JaredTCan/NanoSAM/NanoSAM/nanoSAM_Schematic.pdf

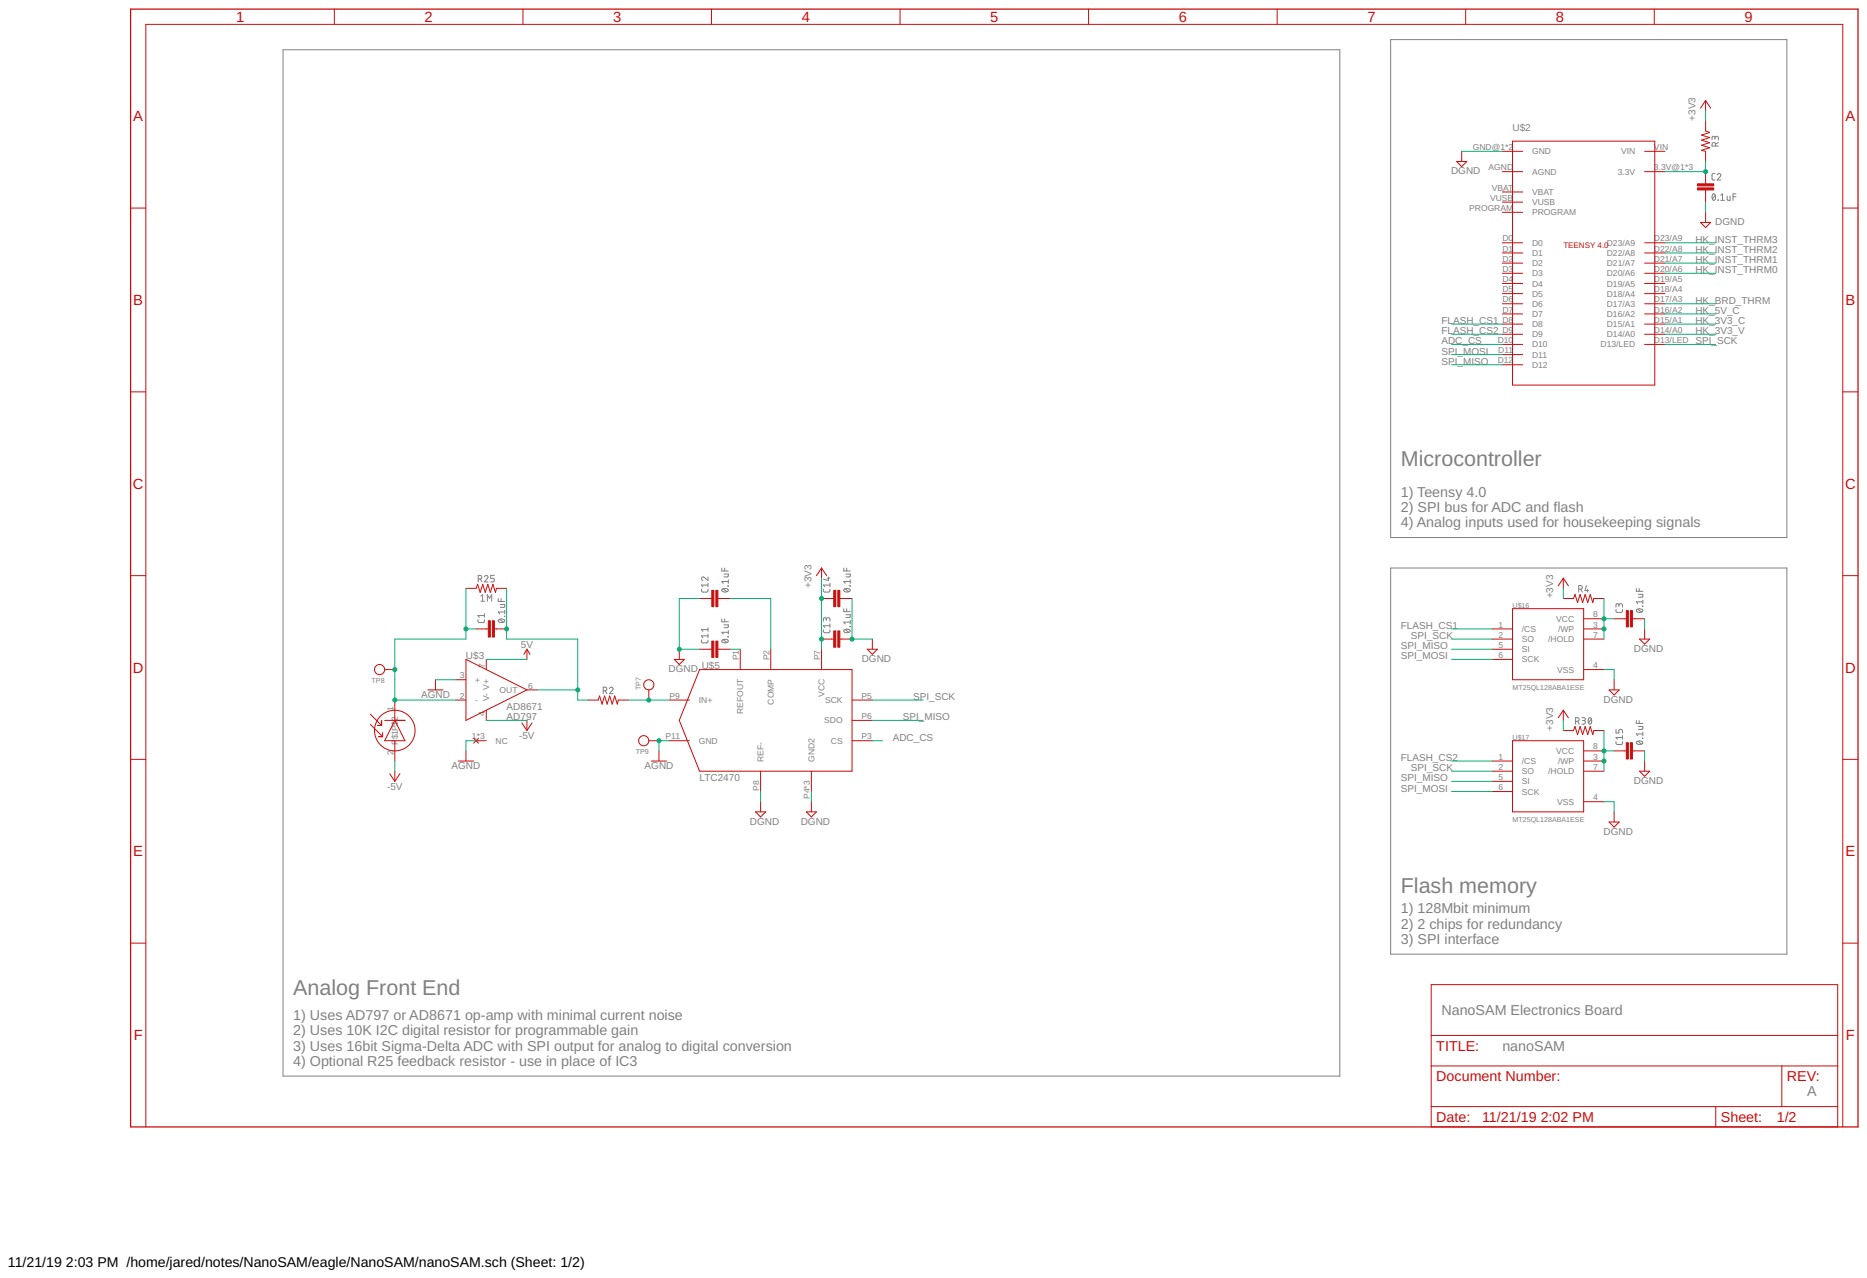
[picture p1: page 1]

1) Teensy 4.0
2) SPI bus for ADC and flash
4) Analog inputs used for housekeeping signals

1) Uses AD797 or AD8671 op-amp with minimal current noise
2) Uses 10K I2C digital resistor for programmable gain
3) Uses 16bit Sigma-Delta ADC with SPI output for analog to digital conversion
4) Optional R25 feedback resistor - use in place of IC3

Document Number: | REV: A

Date: 11/21/19 2:02 PM | Sheet: 1/2

11/21/19 2:03 PM /home/jared/notes/NanoSAM/eagle/NanoSAM/nanoSAM.sch (Sheet: 1/2)

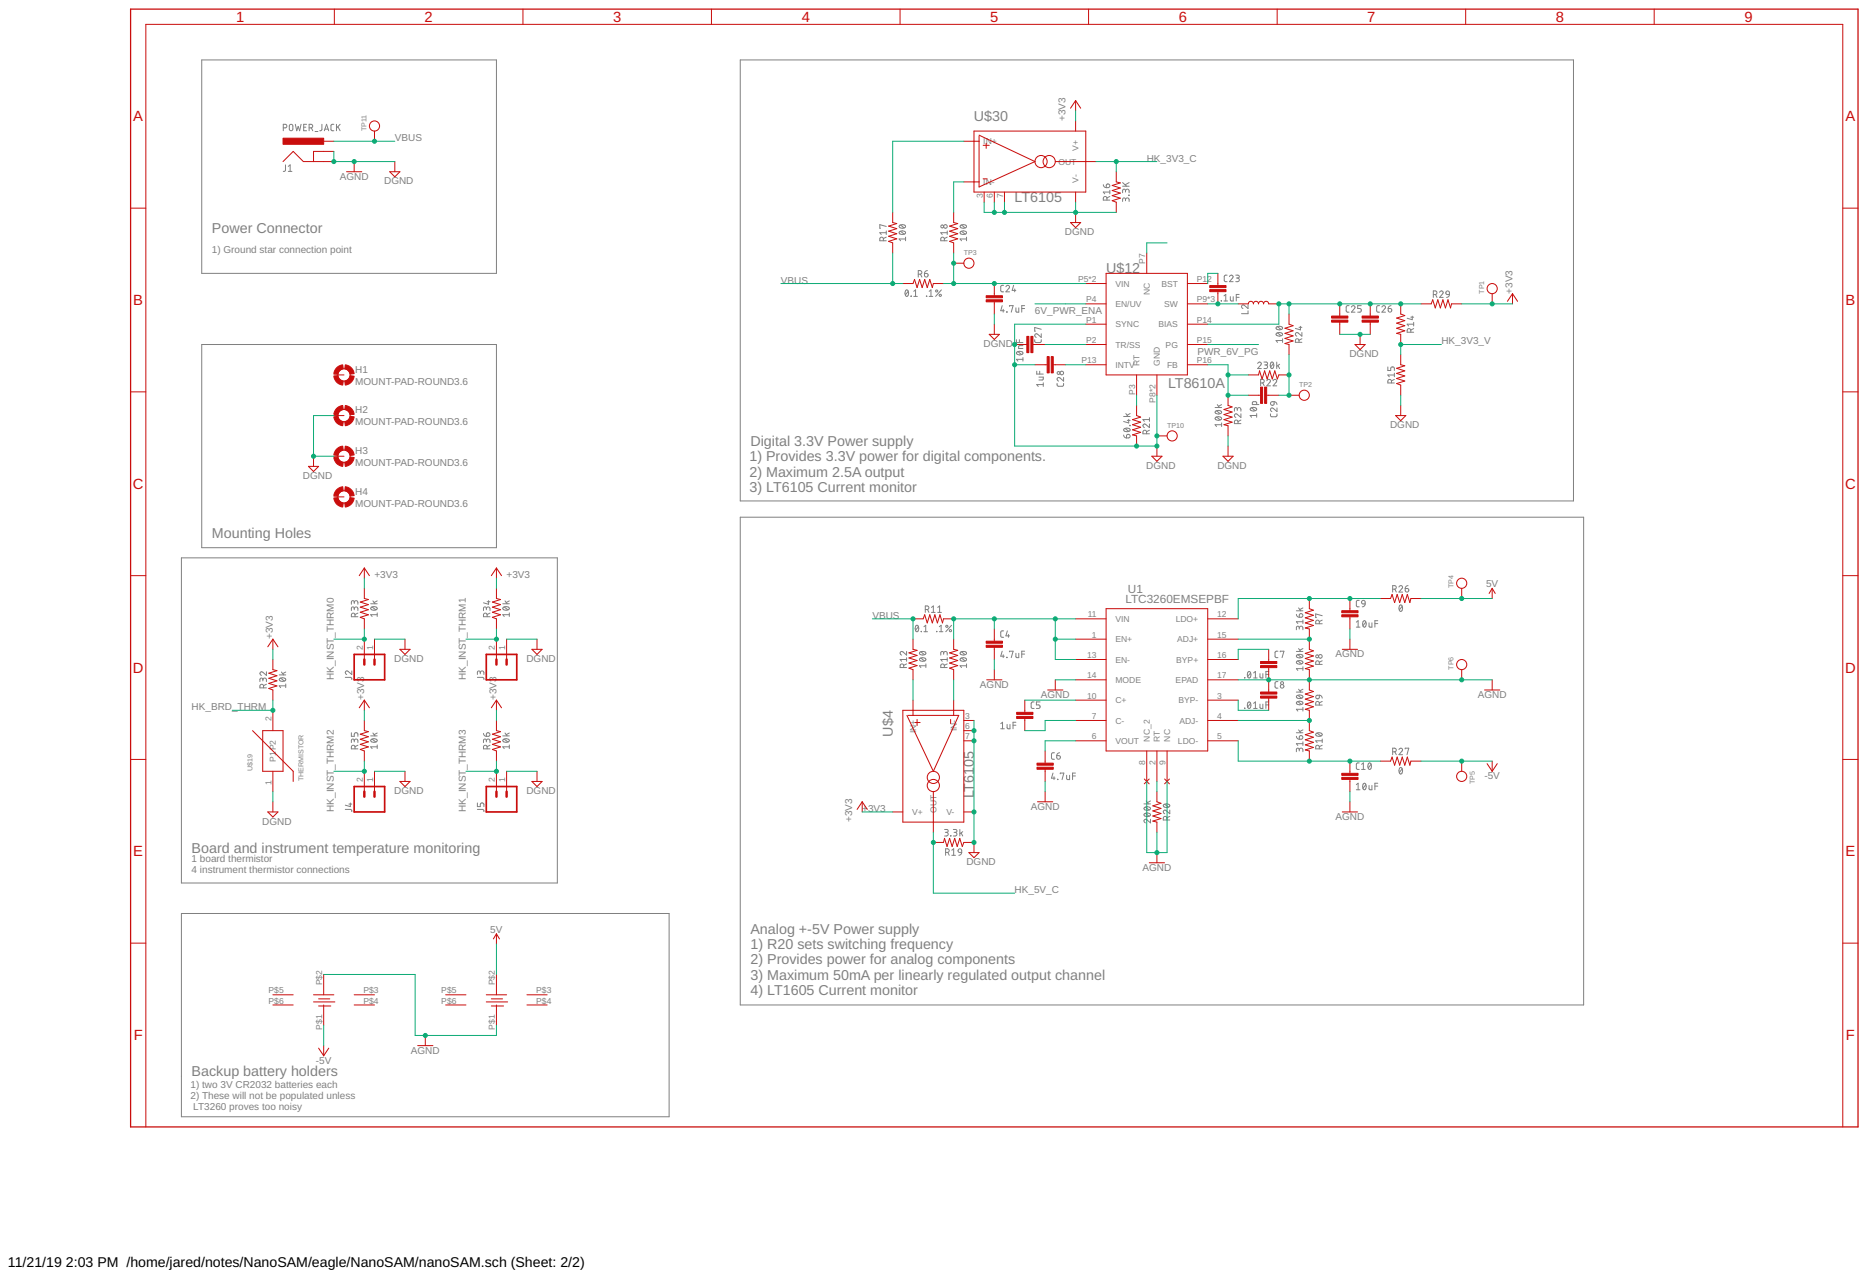
[picture p2: page 2]

1) Ground star connection point

Digital 3.3V Power supply
1) Provides 3.3V power for digital components. 2) Maximum 2.5A output
3) LT6105 Current monitor

Board and instrument temperature monitoring
1 board thermistor 4 instrument thermistor connections

Analog +-5V Power supply
1) R20 sets switching frequency
2) Provides power for analog components
3) Maximum 50mA per linearly regulated output channel
4) LT1605 Current monitor

Backup battery holders
1) two 3V CR2032 batteries each
2) These will not be populated unless LT3260 proves too noisy

11/21/19 2:03 PM /home/jared/notes/NanoSAM/eagle/NanoSAM/nanoSAM.sch (Sheet: 2/2)
