JaredTCan/NanoSAM/NanoSAM/nanoSAM.brd

## EAGLE design NanoSAM/nanoSAM.brd (2020-03-12)

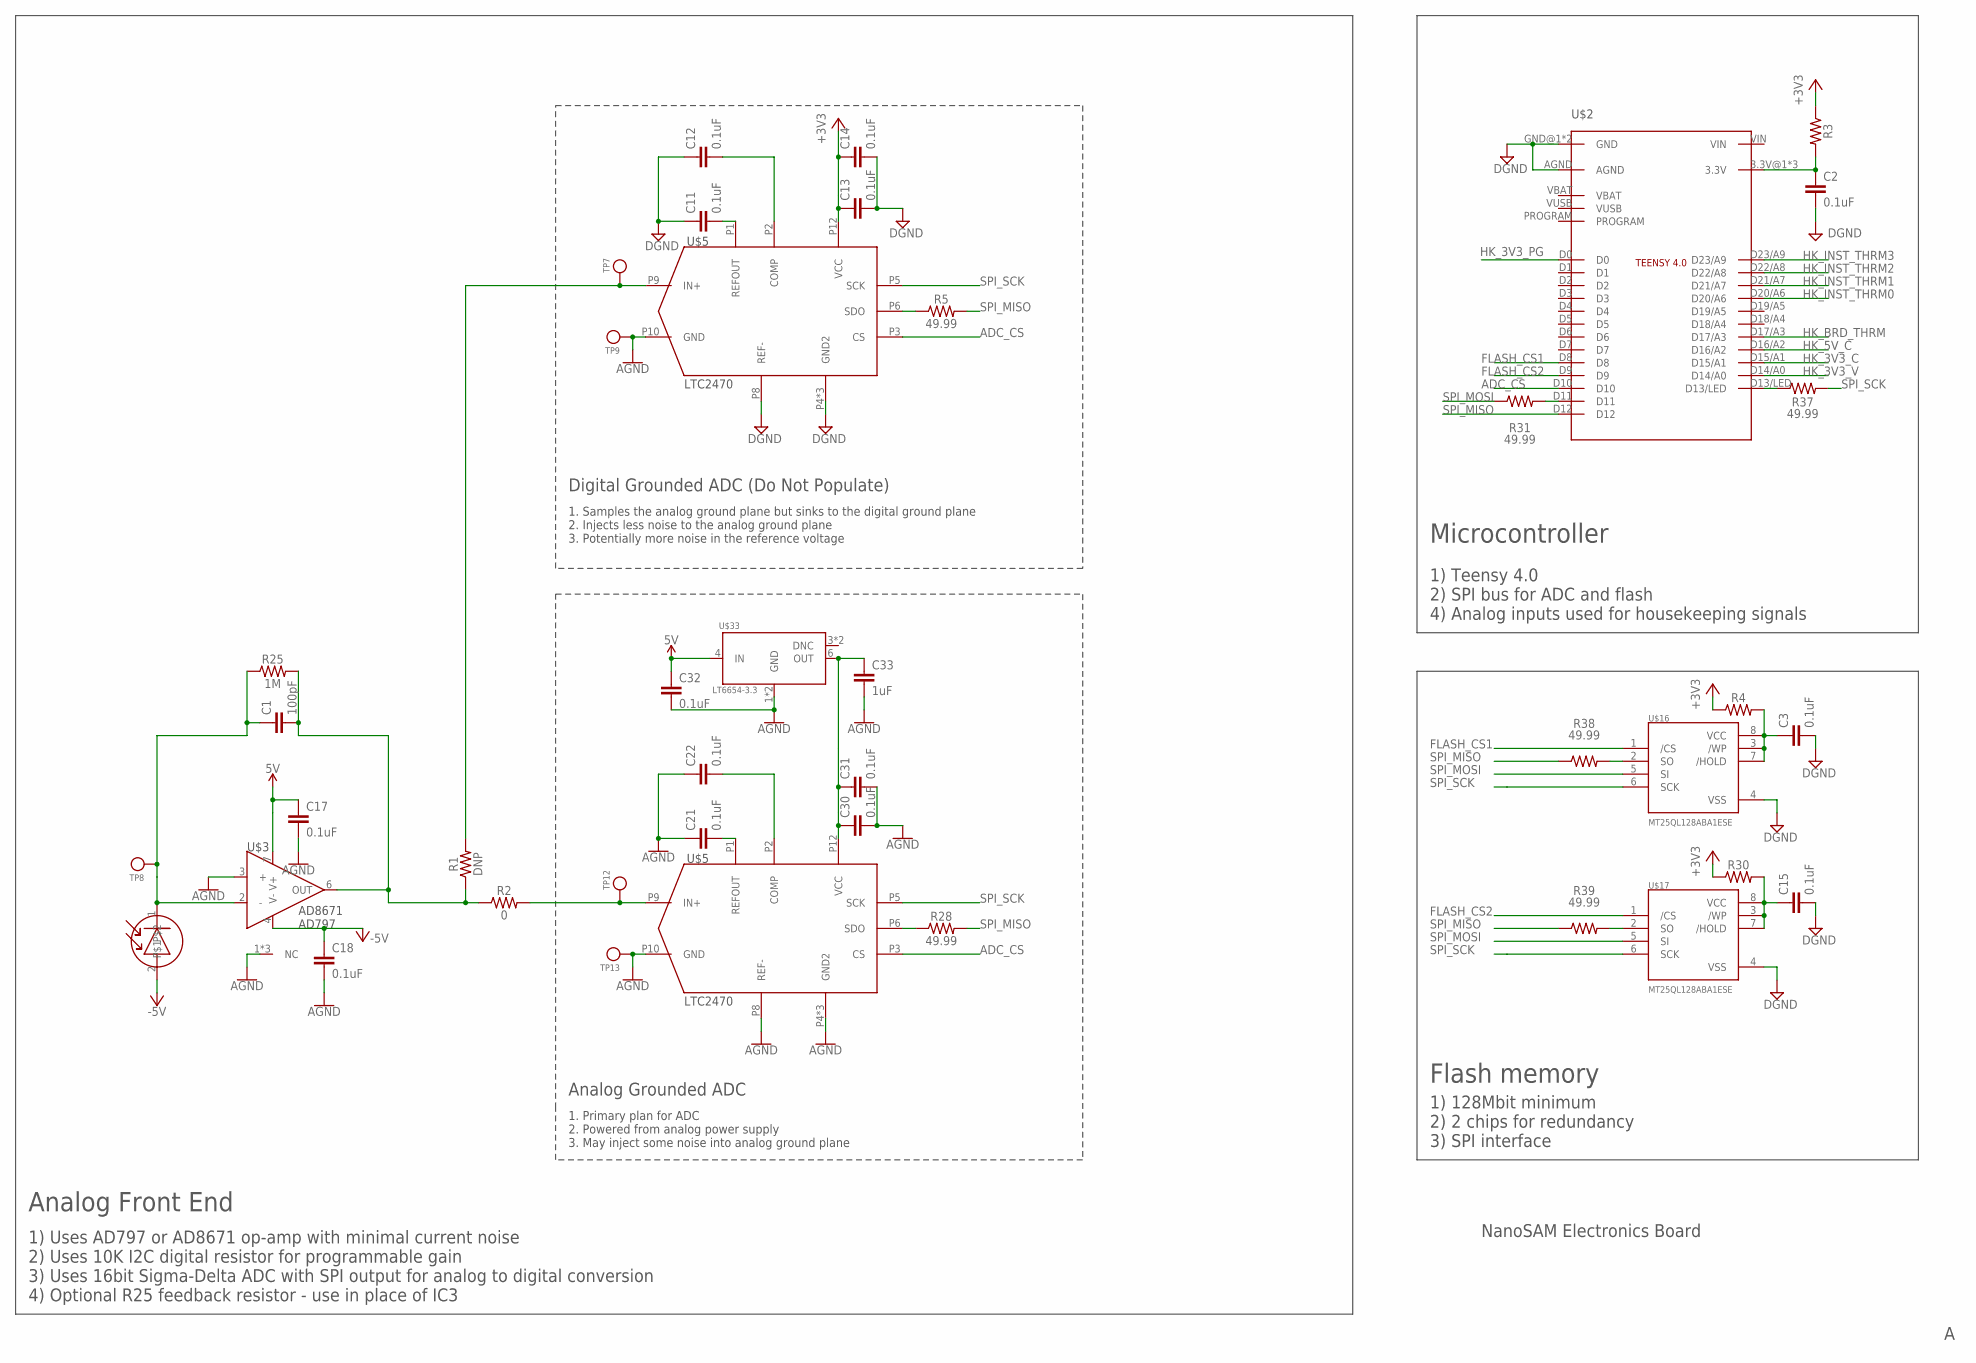
[picture p3: schematic nanoSAM.sch, sheet 1]

Parts:
C1: 100pF; 0603
C2, C3, C11, C12, C13, C14, C15, C17, C18, C21, C22, C30, C31, C32: 0.1uF; 0603
C33: 1uF; 0603
R1: DNP; 0805
R2: 0; 0805
R3, R4, R30: 0805
R5, R28, R31, R37, R38, R39: 49.99; 0805
R25: 1M; 0805
TP7, TP8, TP9, TP12, TP13: TESTPOINT; 1X01
U$1: PHOTODIODESYMBOLPD_CONN; 1X02
U$2: TEENSY4.0
U$3: AD8671; SO8
U$5, U$26: LTC2470; MSOP12
U$16, U$17: MT25QL128ABA1ESE; SO-08M
U$33: LT6654-3.3; SOT23-6L

Connections:
5V: C17.1, C32.1, U$3.7 (V+), U$33.4 (IN); also elsewhere on the board
+3V3: C13.1, C14.1, R3.1, R4.1, R30.1, U$5.P12 (VCC); also elsewhere on the board
-5V: C18.1, U$1.2, U$3.4 (V-); also elsewhere on the board
ADC_CS: U$2.D10, U$5.P3 (CS), U$26.P3 (CS)
AGND: C17.2, C18.2, C21.1, C22.1, C30.2, C31.2, C32.2, C33.2, TP9.1, TP13.1, U$3.1 (NC), U$3.3 (+), U$3.5 (NC), U$3.8 (NC), U$5.P10 (GND), U$26.P4 (GND2), U$26.P7 (GND2), U$26.P8 (REF-), U$26.P10 (GND), U$26.P11 (GND2), U$33.1 (GND), U$33.2 (GND); also elsewhere on the board
DGND: C2.2, C3.2, C11.1, C12.1, C13.2, C14.2, C15.2, U$2.AGND, U$2.GND@1 (GND), U$2.GND@2 (GND), U$5.P4 (GND2), U$5.P7 (GND2), U$5.P8 (REF-), U$5.P11 (GND2), U$16.4 (VSS), U$17.4 (VSS); also elsewhere on the board
FLASH_CS1: U$2.D8, U$16.1 (/CS)
FLASH_CS2: U$2.D9, U$17.1 (/CS)
HK_3V3_C: U$2.D15/A1; also elsewhere on the board
HK_3V3_PG: U$2.D0; also elsewhere on the board
HK_3V3_V: U$2.D14/A0; also elsewhere on the board
HK_5V_C: U$2.D16/A2; also elsewhere on the board
HK_BRD_THRM: U$2.D17/A3; also elsewhere on the board
HK_INST_THRM0: U$2.D20/A6; also elsewhere on the board
HK_INST_THRM1: U$2.D21/A7; also elsewhere on the board
HK_INST_THRM2: U$2.D22/A8; also elsewhere on the board
HK_INST_THRM3: U$2.D23/A9; also elsewhere on the board
unnamed: C1.1, R25.1, TP8.1, U$1.1, U$3.2 (-)
unnamed: C1.2, R1.1, R2.1, R25.2, U$3.6 (OUT)
unnamed: R1.2, TP7.1, U$5.P9 (IN+)
unnamed: C2.1, R3.2, U$2.3.3V@1 (3.3V), U$2.3.3V@2 (3.3V), U$2.ON/OFF (3.3V)
unnamed: R2.2, TP12.1, U$26.P9 (IN+)
unnamed: C3.1, R4.2, U$16.3 (/WP), U$16.7 (/HOLD), U$16.8 (VCC)
unnamed: C22.2, U$26.P2 (COMP)
unnamed: C12.2, U$5.P2 (COMP)
unnamed: C11.2, U$5.P1 (REFOUT)
unnamed: C21.2, U$26.P1 (REFOUT)
unnamed: C30.1, C31.1, C33.1, U$26.P12 (VCC), U$33.6 (OUT)
unnamed: C15.1, R30.2, U$17.3 (/WP), U$17.7 (/HOLD), U$17.8 (VCC)
unnamed: R5.1, U$5.P6 (SDO)
unnamed: R28.1, U$26.P6 (SDO)
unnamed: R31.2, U$2.D11
unnamed: R37.1, U$2.D13/LED
unnamed: R38.2, U$16.2 (SO)
unnamed: R39.2, U$17.2 (SO)
SPI_MISO: R5.2, R28.2, R38.1, R39.1, U$2.D12
SPI_MOSI: R31.1, U$16.5 (SI), U$17.5 (SI)
SPI_SCK: R37.2, U$5.P5 (SCK), U$16.6 (SCK), U$17.6 (SCK), U$26.P5 (SCK)

Notes on the sheet:
Analog Front End
Microcontroller
Flash memory
1) Uses AD797 or AD8671 op-amp with minimal current noise 2) Uses 10K I2C digital resistor for programmable gain 3) Uses 16bit Sigma-Delta ADC with SPI output for analog to digital conversion 4) Optional R25 feedback resistor - use in place of IC3
1) Teensy 4.0 2) SPI bus for ADC and flash 4) Analog inputs used for housekeeping signals
1) 128Mbit minimum 2) 2 chips for redundancy 3) SPI interface
AD8671 AD797
U$3
U$2
LTC2470
U$5
NanoSAM Electronics Board
Analog Grounded ADC
1. Primary plan for ADC 2. Powered from analog power supply 3. May inject some noise into analog ground plane
Digital Grounded ADC (Do Not Populate)
1. Samples the analog ground plane but sinks to the digital ground plane 2. Injects less noise to the analog ground plane 3. Potentially more noise in the reference voltage

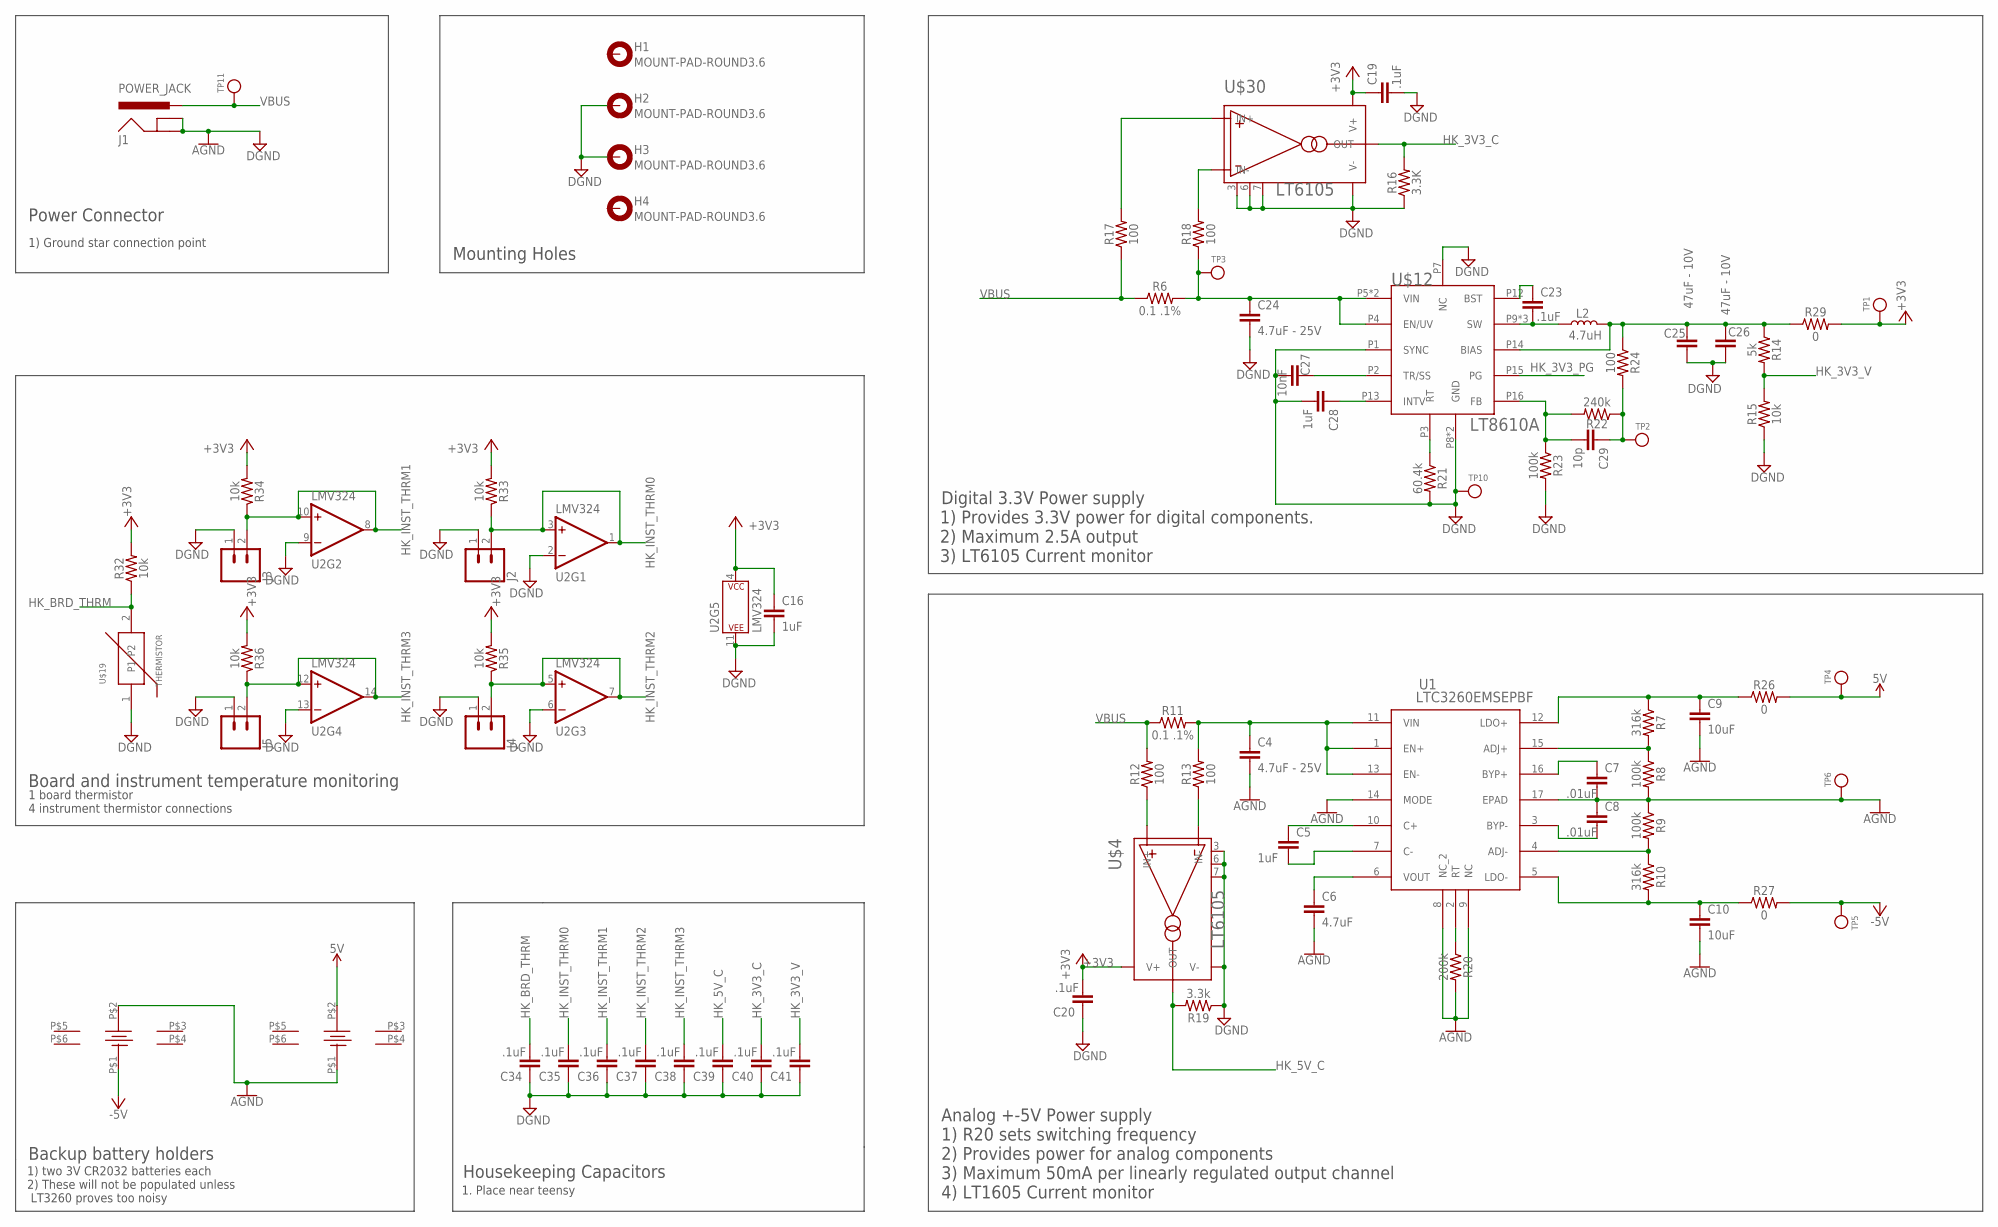
[picture p4: schematic nanoSAM.sch, sheet 2]

Parts:
C4, C24: 4.7uF - 25V; 1206
C5: 1uF; 1206
C6: 4.7uF; 1206
C7, C8: .01uF; 1206
C9, C10: 10uF; 1206
C16, C28: 1uF; 0603
C19, C20, C23, C34, C35, C36, C37, C38, C39, C40, C41: .1uF; 0603
C25, C26: 47uF - 10V; 1210
C27: 10nF; 0603
C29: 10p; 0603
H1, H2, H3, H4: MOUNT-PAD-ROUND3.6; 3,6-PAD
J1: POWER_JACK; POWER_JACK_PTH
J2, J3, J4, J5: CONN_02; 1X02
L2: 4.7uH; WE-HCI
R6, R11: 0.1 .1%; 1206
R7, R10: 316k; 0603
R8, R9, R23: 100k; 0603
R12, R13, R17, R18, R24: 100; 0603
R14: 5k; 0603
R15: 10k; 0603
R16: 3.3K; 0603
R19: 3.3k; 0603
R20: 200k; 0603
R21: 60.4k; 0603
R22: 240k; 0603
R26, R27: 0; 0603
R29: 0; 1206
R32, R33, R34, R35, R36: 10k; 1206
TP1, TP2, TP3, TP4, TP5, TP6, TP10, TP11: TESTPOINT; 1X01
U1: LTC3260EMSEPBF; MSOP-16_MSE
U2: LMV324; SO14
U$4, U$30: LT6105; MSOP8
U$12: LT8610A; MSOP16
U$19: THERMISTOR; M0805
U$20, U$21: CR2032

Connections:
5V: R26.2, TP4.1, U$21.P$2; also elsewhere on the board
+3V3: C16.1, C19.1, C20.2, R29.2, R32.2, R33.2, R34.2, R35.2, R36.2, TP1.1, U2.4 (P$V+), U$4.2 (V+), U$30.2 (V+); also elsewhere on the board
-5V: R27.2, TP5.1, U$20.P$1; also elsewhere on the board
AGND: C4.2, C6.2, C7.2, C8.1, C9.2, C10.2, R8.2, R9.1, R20.2, TP6.1, U1.8 (NC_2), U1.9 (NC), U1.14 (MODE), U1.17 (EPAD), U$20.P$2, U$21.P$1; also elsewhere on the board
DGND: C16.2, C19.2, C20.1, C24.2, C25.2, C26.2, C27.2, C28.2, C34.1, C35.1, C36.1, C37.1, C38.1, C39.1, C40.1, C41.1, H2.B3,6, H3.B3,6, J1.GND, J1.GNDBREAK, J2.1, J3.1, J4.1, J5.1, R15.1, R16.1, R19.1, R21.2, R23.2, TP10.1, U2.2 (-IN), U2.6 (-IN), U2.9 (-IN), U2.11 (P$V-), U2.13 (-IN), U$4.3, U$4.4 (V-), U$4.6, U$4.7, U$12.P1 (SYNC), U$12.P7 (NC), U$12.P8 (GND), U$12.P17 (GND), U$19.1, U$30.3, U$30.4 (V-), U$30.6, U$30.7; also elsewhere on the board
HK_3V3_C: C40.2, R16.2, U$30.5 (OUT); also elsewhere on the board
HK_3V3_PG: U$12.P15 (PG); also elsewhere on the board
HK_3V3_V: C41.2, R14.2, R15.2; also elsewhere on the board
HK_5V_C: C39.2, R19.2, U$4.5 (OUT); also elsewhere on the board
HK_BRD_THRM: C34.2, R32.1, U$19.2; also elsewhere on the board
HK_INST_THRM0: C35.2, J2.2, R33.1, U2.1 (OUT), U2.3 (+IN); also elsewhere on the board
HK_INST_THRM1: C36.2, J3.2, R34.1, U2.8 (OUT), U2.10 (+IN); also elsewhere on the board
HK_INST_THRM2: C37.2, J4.2, R35.1, U2.5 (+IN), U2.7 (OUT); also elsewhere on the board
HK_INST_THRM3: C38.2, J5.2, R36.1, U2.12 (+IN), U2.14 (OUT); also elsewhere on the board
unnamed: C7.1, U1.16 (BYP+)
unnamed: R7.2, R8.1, U1.15 (ADJ+)
unnamed: C6.1, U1.6 (VOUT)
unnamed: R17.2, U$30.8 (IN+)
unnamed: R9.2, R10.1, U1.4 (ADJ-)
unnamed: R18.2, U$30.1 (IN-)
unnamed: C8.2, U1.3 (BYP-)
unnamed: C4.1, R11.2, R13.2, U1.1 (EN+), U1.11 (VIN), U1.13 (EN-)
unnamed: R12.1, U$4.8 (IN+)
unnamed: R13.1, U$4.1 (IN-)
unnamed: C5.1, U1.10 (C+)
unnamed: C5.2, U1.7 (C-)
unnamed: C9.1, R7.1, R26.1, U1.12 (LDO+)
unnamed: R20.1, U1.2 (RT)
unnamed: C10.1, R10.2, R27.1, U1.5 (LDO-)
unnamed: C28.1, U$12.P13 (INTV)
unnamed: C25.1, C26.1, L2.P$2 (2), R14.1, R24.1, R29.1, U$12.P14 (BIAS)
unnamed: C27.1, U$12.P2 (TR/SS)
unnamed: R21.1, U$12.P3 (RT)
unnamed: C23.1, U$12.P12 (BST)
unnamed: C23.2, L2.P$1 (1), U$12.P9 (SW), U$12.P10 (SW), U$12.P11 (SW)
unnamed: C29.2, R22.2, R23.1, U$12.P16 (FB)
unnamed: C29.1, R22.1, R24.2, TP2.1
unnamed: C24.1, R6.2, R18.1, TP3.1, U$12.P4 (EN/UV), U$12.P5 (VIN), U$12.P6 (VIN)
VBUS: J1.PWR, R6.1, R11.1, R12.2, R17.1, TP11.1

Notes on the sheet:
Digital 3.3V Power supply
Analog +-5V Power supply
Power Connector
1) Ground star connection point
Mounting Holes
1) R20 sets switching frequency 2) Provides power for analog components 3) Maximum 50mA per linearly regulated output channel 4) LT1605 Current monitor
1) Provides 3.3V power for digital components. 2) Maximum 2.5A output 3) LT6105 Current monitor
Board and instrument temperature monitoring
1 board thermistor 4 instrument thermistor connections
Backup battery holders
1) two 3V CR2032 batteries each 2) These will not be populated unless LT3260 proves too noisy
Housekeeping Capacitors
1. Place near teensy

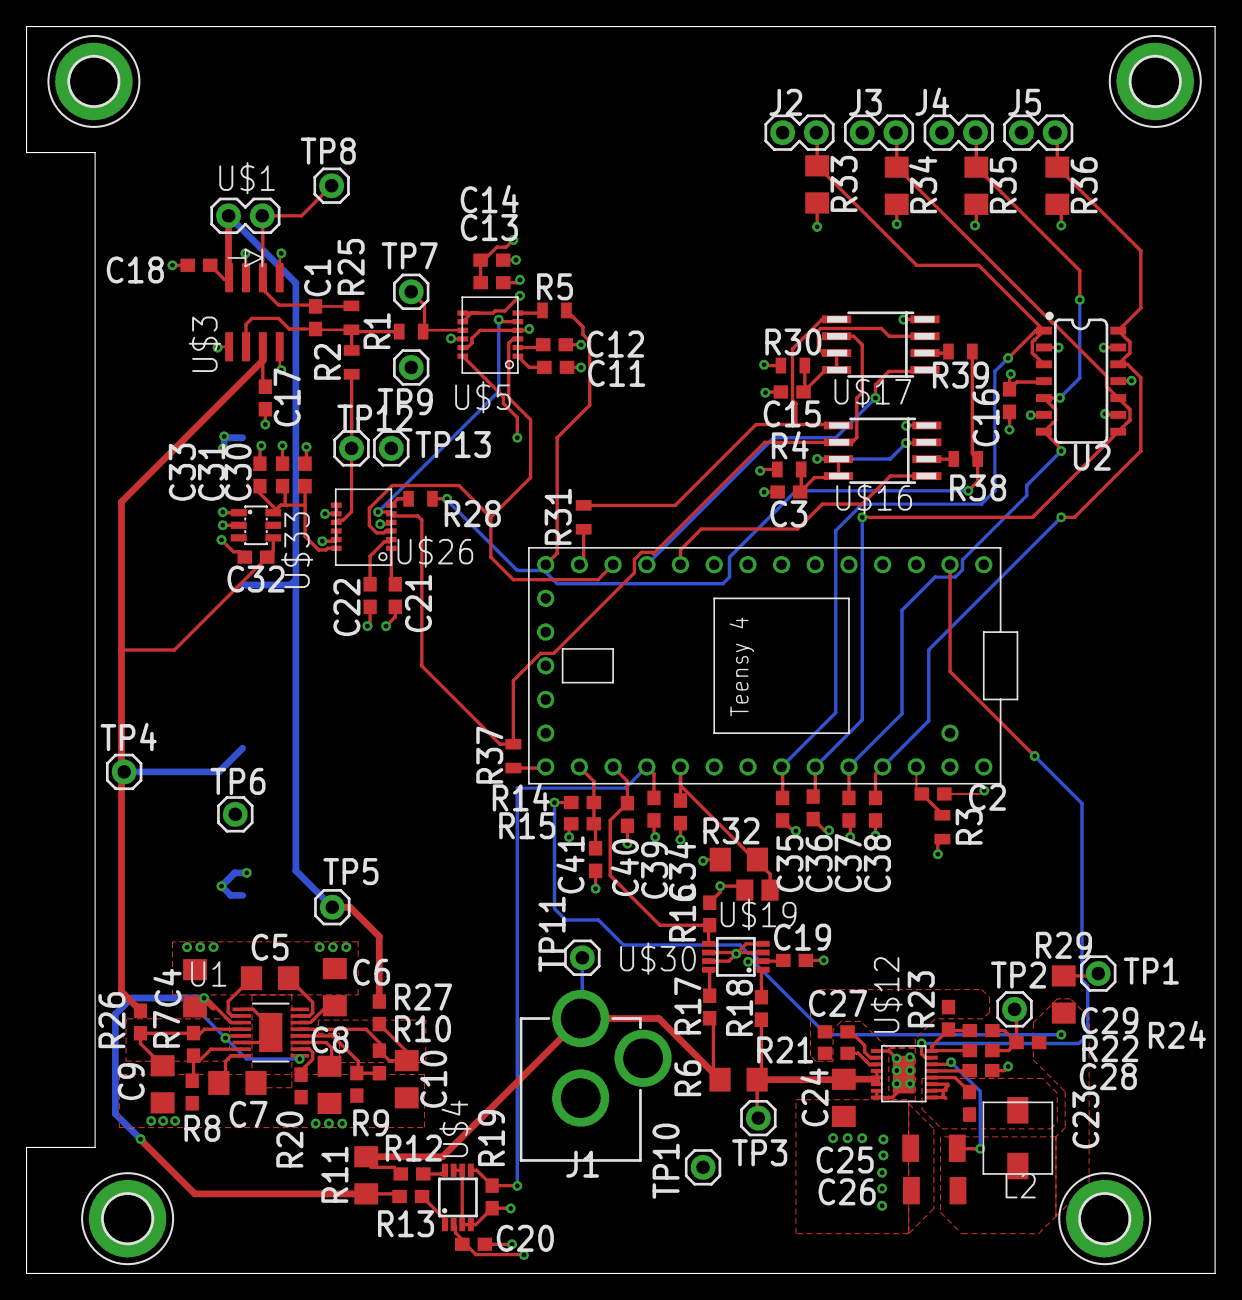
[picture p5: board nanoSAM.brd from above]

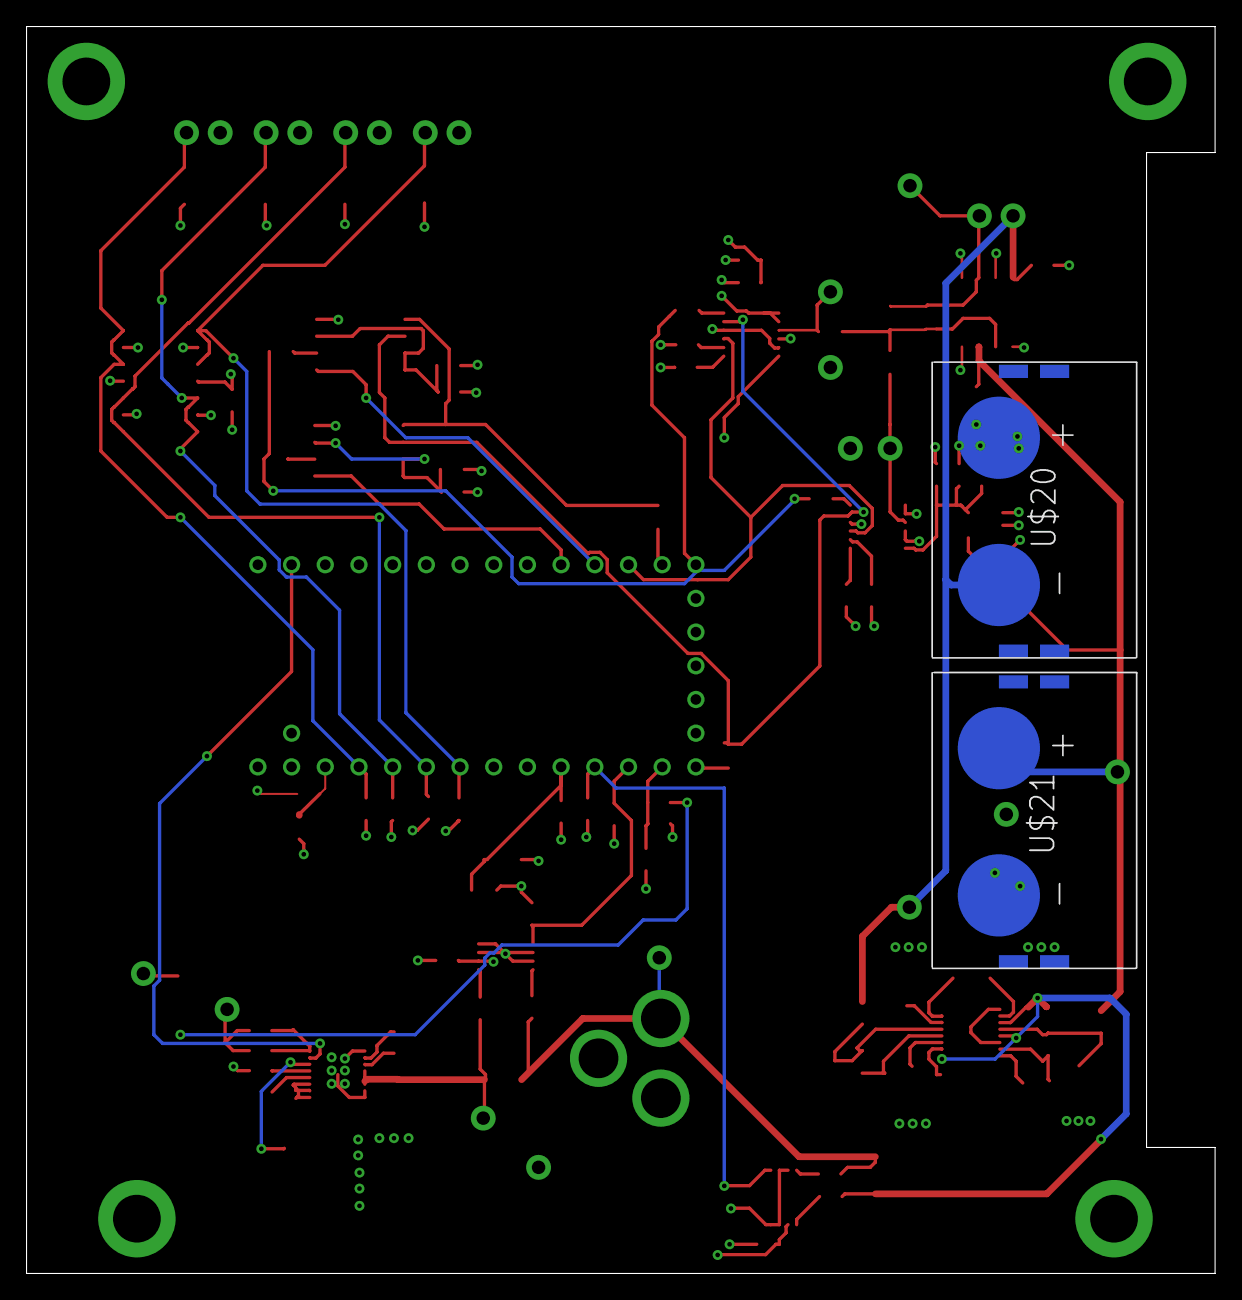
[picture p6: board nanoSAM.brd from below]

Board: 4 copper layers, 89.6 x 94.0 mm, 119 parts (2 on the bottom side), 63 nets.
