JaredTCan/NanoSAM/(commit log)

2019-10-27 added schematic
    [nanoSAM.sch]
2019-10-27 updated schematic
    [nanoSAM.sch]
2019-10-27 Added ADC library part
2019-10-27 updated sch
    [nanoSAM.sch]
2019-10-28 added teensy 4.0 library
2019-10-28 added teensy library successfully
2019-11-09 Split analog and digital grounds
    [nanoSAM.brd]
2019-11-09 Updated teensy to 4.0, added analog housekeeping signals to teensy
    [nanoSAM.sch]
2019-11-09 Added flash chips
    [nanoSAM.brd, nanoSAM.sch]
2019-11-09 added mounting holes
    [nanoSAM.brd, nanoSAM.sch]
2019-11-09 added schematic pdf
2019-11-12 added thermistors for temp monitoring and changed current monitoring circuit
    [nanoSAM.brd, nanoSAM.sch]
2019-11-13 added more thermistor connections
    [nanoSAM.brd, nanoSAM.sch]
2019-11-14 started layout
    [nanoSAM.brd]
2019-11-15 routed analog signals, added R3 and C2 by microcontroller
    [nanoSAM.brd]
2019-11-15 added power plane
    [nanoSAM.brd]
2019-11-15 Added R4, R30, C15, C14 to flash.
    [nanoSAM.brd]
2019-11-15 moved some resistors around
    [nanoSAM.brd]
2019-11-15 Edited Bipolar power supply
    [nanoSAM.brd, nanoSAM.sch]
2019-11-17 routed +3v3 power supply
    [nanoSAM.brd, nanoSAM.sch]
2019-11-17 Finished part placements and bus wiring
    [nanoSAM.brd, nanoSAM.sch]
2019-11-17 fixed some DRC errors
    [nanoSAM.brd, nanoSAM.sch]
2019-11-18 Fixed labels and started to add coin cell battery backup
    [nanoSAM.brd, nanoSAM.sch]
2019-11-20 Added Coin Cell Battery library, schematic, and board.
    [nanoSAM.brd, nanoSAM.sch]
2019-11-21 added some documentation to schematic, added datasheets folder
    [nanoSAM.brd, nanoSAM.sch]
2019-11-25 added unity gain op-amp buffer for instrument housekeeping
    [nanoSAM.brd, nanoSAM.sch]
2019-12-01 added some stuff, fixed some stuff
    [nanoSAM.brd, nanoSAM.sch]
2019-12-14 updated some stuff
    [nanoSAM.brd, nanoSAM.sch]
2019-12-14 added options for grounding ADCs
    [nanoSAM.brd, nanoSAM.sch]
2019-12-14 Added analog grounded ADC power regulator
    [nanoSAM.brd, nanoSAM.sch]
2019-12-14 Finished fixing stuff
    [nanoSAM.brd, nanoSAM.sch]
2019-12-14 changed a border for the A E S T H E T I C
    [nanoSAM.brd, nanoSAM.sch]
2019-12-14 more A E S T H E T I C
    [nanoSAM.sch]
2019-12-14 Added HK Capacitors
    [nanoSAM.brd, nanoSAM.sch]
2019-12-15 added changes to PCB board layout including 3.3V linear regulator
    [nanoSAM.brd, nanoSAM.sch]
2019-12-15 fixed some PCB issues
    [nanoSAM.brd, nanoSAM.sch]
2020-01-12 Updated board dimensions to match stack plate
    [nanoSAM.brd]
2020-01-15 updated some values
    [nanoSAM.brd, nanoSAM.sch]
2020-01-15 added BOM
    [nanoSAM.csv]
2020-01-24 added manufacturing files
    [nanoSAM.brd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]
2020-03-09 fixed footprint, broke other things
    [nanoSAM.brd, nanoSAM.sch]
2020-03-12 updated PCB
    [nanoSAM.brd]
